juanmcasillas/Sun2UsbAdapter/dev/suniversal/CHANGELOG.md

# Change Log

## v0.4.2
- doc updates
- new setting `COMPOSE_LED_HOST_CONTROLLED` (see issue #5)
- more debug log info (see issues #5 and #6)

## v0.4.1
- mouse wheel emulation for vertical and horizontal scrolling
- refactoring

## v0.4.0
- mouse support: both 5-byte *Mousesystems* protocol and 3-byte *SUN* protocol are automatically handled

## v0.3.1
- refactoring: extracted USB-related code from NicoHood's HID library, so project is no longer required as a submodule

## v0.3.0
- switched to [NicoHood's HID](https://github.com/NicoHood/HID) project instead of the *Arduino* core library for USB HID
- boot protocol support
- keyboard LEDs now properly controlled by host
- refactoring

## v0.2.0
- macros for fun cluster keys
- several configuration items
- bug fixes

## Holiday Hack
- initial version with base functionality
