juanmcasillas/Sun2UsbAdapter/(commit log)

2024-07-22 fixed and integrated SUN_WIN fix
    [config.h, keyboard.cpp, sun_to_usb_win.h]
2024-07-22 merged the inverted and windows map in the same tree
    [AltSoftSerial_Boards.h, InvAltSoftSerial.cpp, InvAltSoftSerial.h, config.h, keyboard.cpp, suniversal.ino]
